krisxia0506/codex-micro/docs/research/assets/README.md

# 产品参考配图

采集日期：2026-10-23。以下图片用于说明参考键盘的外观与控件，不是本项目的样机。

| 文件 | 来源页 | 原始资源 |
| --- | --- | --- |
| `codex-micro-product.png` | [Work Louder 产品页](https://worklouder.cc/codex-micro) | [产品正面图](https://framerusercontent.com/images/HkVNgcwB7n5BW1AUhyku6lIpD4.png?lossless=1&width=1377&height=1394) |
| `codex-micro-command-keys.png` | [Work Louder 产品页](https://worklouder.cc/codex-micro) | [命令键展示图](https://framerusercontent.com/images/bHkJ1NsgylwMciKPLwxa0FzZw.png) |

图片保留原始文件，权利归原权利人所有，不在本项目 MIT 授权范围内；详见 [NOTICE](../../../NOTICE)。未取得额外的再分发或商用授权。

`checksums.sha256` 记录保存文件的 SHA-256，可在本目录运行 `shasum -a 256 -c checksums.sha256` 验证文件完整性。
