krisxia0506/codex-micro/docs/model-workbench.md

# 3D 模型工作台

首版展示和下载同源的概念键盘零件。当前含装配结构试样，不是经过硬件适配或实际打印验证的键盘套件。

v0.22 的按键电气原型另见 [电路图、物料清单与焊接教程](hardware/key-matrix.md)。该教程定义真实的矩阵网络；本页 3D 飞线仍仅展示空间路径，没有同步成 GPIO 接线图。新加二极管和实际线束需要现场验证净空。

## 运行

使用 Node.js 22.12+（或 24/26）与 npm：

```bash
npm ci
npm run dev
```

打开终端输出的本地地址。拖动旋转、滚轮缩放、右键平移；拖动拆解滑杆查看层级。可点击模型或列表选择零件、逐件隐藏、查看线框、恢复全部显示和重置视角。

```bash
npm test
npm run build
npm run export:stl
```

构建生成 `dist/` 静态网站，可部署到静态服务器。单独导出生成 `exports/stl/` 中的 17 个模型零件 STL 和 1 个单底座试配 STL，以及 `exports/manifest.json` 和 `public/codex-micro-stl.zip`。生成物不纳入 Git，由源码重建。网页支持所选零件下载和整套 ZIP 下载。

## 模型与导出约定

- [几何源文件](../web/model.js) 定义零件 ID、几何、组装位置、颜色、拆解层级和说明；[网页入口](../web/main.js) 负责交互，[导出脚本](../scripts/model/export.mjs) 在 Node 中使用同一几何源。
- Z 向上，长度单位毫米。当前外形草案为 110 × 110 mm，底板主体 2 mm（周边及安装位局部 4 mm）、围框 7 mm、轴体板 1.5 mm（螺丝孔周围向下加厚至 2.5 mm）。均为设计假设，不是参考产品的实测尺寸。
- 每个 STL 使用零件局部坐标并落到 Z=0；不会把网页拆解位移写进打印文件。STL 自身不记录单位，在切片器选择 mm。
- 低位定位板按轴体位置开 14.2 mm 方孔，孔宽与板厚仍待实物验证。键帽已含底部空腔和 MX 十字安装盲孔；旋钮和摇杆帽仍为实心占位件，没有实际连接接口。
- 底板、围框、定位板为三个独立样件，已有定位凸沿、螺丝支柱和一体底座卡槽；开发板固定、USB 开孔及功能控件接口尚未完成，不能直接装成可用键盘。
- 模型结构由参数和循环构造，改动尺寸需同步评估壁厚、孔位、间隙。当前不提供网页在线改尺寸或 STEP/B-rep CAD。

## 验证范围

自动测试对全部 STL 回读，检查有限坐标、每条边恰好连接两个面、边方向一致、正体积以及打印底面 Z=0。对齐矩形孔的三角化会产生 T 接点，几何生成器会分割对应边，保证邻接完整。

这些检查不代替切片和实物验证。打印前在切片器确认尺寸、摆放、支撑和最小特征；材料收缩、打印间隙、结构强度及装配需要样件测试。下一步确定轴体、PCB、编码器、接口与紧固方式后再完善工程结构。

## 历史 v0.2 外观与电子布局（已由 v0.3 飞线方案替代）

外壳使用圆角轮廓，键帽增加倒角；展示增加按键字符、状态灯窗、旋钮滚花、摇杆防滑环。圆角和键帽倒角进入同源 STL；字符、灯窗、滚花与丝印属于网页渲染细节，不包含在 STL 中。

新增 16 个电子占位件：PCB、10 个机械轴体、编码器、摇杆模块、USB-C、主控和电源芯片。PCB 展示焊盘、固定孔、丝印与示意走线；没有电路网表和可制造 PCB 数据。界面可切换“仅看电子层”，标注跟随旋转和拆解更新，点击标注查看对应说明。完整组装时默认不显示内部标注，拆解或隐藏上盖后显示。

所有电子位置、尺寸与外形仅用于布局交流，不能视为供应商尺寸或已通过装配检查。没有选择集成麦克风或电池方案，因此没有虚构其确定安装位置。电子件设为不可打印，网页禁止单件 STL 导出，整套 ZIP 仍仅包含 15 个外观打印试样。

全部 12 个键帽（任务键、命令键、语音键和发送键）、旋钮及摇杆帽，共 14 个零件，在零件列表中归为默认折叠的“键帽组”。展开后可选择单键、控制显隐和下载；组复选框控制全部键帽、旋钮及摇杆帽显隐，部分隐藏时显示半选状态。点击模型中的键帽会自动展开分组。分组只改变展示层级，不合并打印几何；电子轴体归入独立的“轴体组”。

## v0.3 手工飞线结构（架构沿用，布局由 v0.4 更新）

按用户确定的方向取消整块键盘 PCB，仅保留 XIAO nRF52840 Sense Plus 开发板，键轴通过软线连接主控。原来独立的 MCU、电源管理与 USB-C 占位移除，相关功能统一在开发板示意中展示。

开发板外形按 [Seeed 官方资料](https://wiki.seeedstudio.com/XIAO_BLE/) 的 21 × 17.8 mm 比例建模。官方确认 Sense Plus 配备 PDM 麦克风与 IMU。展示中的元件位置、高度和焊盘仅为示意，并非官方精确 CAD。USB 插拔空间、固定方式、麦克风声孔及天线净空尚未做工程验证。

轴体底部放置一组 10 个热插拔底座，其下为打印承托框组。用户已确认凯华 Kailh MX 热插拔底座，具体料号和尺寸尚待核对；承托框内孔 14.6 × 6.6 mm 是布局假设，没有实际锁止卡扣，也没有与外壳连接的结构，不能直接用于固定实物。新增的第 16 个 STL 是承托框位置试样，必须按底座型号调整后才能做装配件。也可改为轴体直接焊线方案。

蓝色与棕色软线仅表达底座到开发板的走线空间，**不是接线图**：端点不对应实际 GPIO，尚未确定矩阵或直连、二极管方向、旋钮及摇杆配线、供电方案和固件。不得按此展示焊线。线束可以独立隐藏，与电子层一起拆解；不进入打印包。

网页“仅看电子层”包含底座承托框，以展示底座与打印件的关系。尚未进行实际打印、插拔寿命、焊接和电气测试。

## v0.4 参考图布局修正（布局沿用）

对照仓库已有[官方正面参考图](research/assets/codex-micro-product.png)与[命令键参考图](research/assets/codex-micro-command-keys.png)，将原先错误的两排三列任务键改为四列骨架：第一排为旋钮、两枚任务键、摇杆；第二排四枚任务键；第三排快速模式、批准、拒绝、分支对话；第四排为左侧圆形触控区外观、居中双宽语音键、右侧发送键。

12 枚可见键帽对应 13 个轴体位置，语音键下方两轴。轴体、底座及承托框同步到新布局，XIAO 飞线结构保持。打印包现在有 18 个 STL，旧包和旧键号（尤其 key-10/key-11/key-12）不可混用。

键帽采用封闭凹面网格，凹面同步进入 STL。任务键的半透明材质、中心圆点、命令图标、旋钮斜槽和四角螺钉是渲染细节，不作为可装配结构。圆形触控区也仅为外观示意，没有实现触控电路。参考图用于布局和比例对照，110 mm 方形外壳、键距和高度均为自研设计假设，不能视为官方实测尺寸或 1:1 工程复刻。宽键的双轴固定、行程与稳定性仍待验证。

## v0.5 悬浮按键结构（历史）

取消原先 Z=17 的高位上盖及键帽轮廓孔，改为 Z=10、厚 1.5 mm 的低位轴体定位板，围框高度从 14 mm 降为 7 mm。键帽下沿仍在 Z=18，定位板顶面为 Z=11.5，因此按键侧面和轴体上部外露。定位板仍使用 `top.stl` 文件名，但结构与旧版不兼容。

定位板改为 13 个 14.2 mm 轴孔（宽语音键下两个），不再用上盖围住键帽。孔宽、板厚和卡扣适配仍是待验证假设；并非官方结构尺寸。XIAO、热插拔底座与飞线方案保留。外露式结构与最终固定、绝缘、支撑设计仍需实物检验。

## v0.6 可装配外壳与底座卡位（结构沿用）

网页的「固定结构」展示上下凸沿、三层壳体及紧固件；「底座卡槽」单独展示连体承托槽与底座的对应位置。底座卡位已并入 `bottom.stl`，旧的 `socket-carriers.stl` 不再导出。整套 ZIP 增加 `socket-fit-coupon.stl`，网页也可单独下载此试配件。

### 尺寸依据

采用凯华普通 MX 底座 **PG151101S11 / CPG151101S11**，不使用 Choc 矮轴底座尺寸。来源为 [凯华产品页](https://kailhswitch.net/products/kailh-hot-swap-pcb-socket-diy-mechanical-keyboard-switches)和 [凯华原厂尺寸图（Keyboardio 镜像，2016-04-11，单位 mm）](https://github.com/keyboardio/keyswitch_documentation/blob/master/datasheets/Kailh/PG151101S11-MX-Socket.pdf)。图纸标注：

| 项目 | 图纸尺寸（mm） |
| --- | --- |
| 焊脚总跨度 | 14.50 ± 0.15 |
| 塑料主体上缘宽度 / 基部宽度 | 11.30 ± 0.15 / 10.90 ± 0.10 |
| 最大深度 | 5.89 ± 0.10 |
| 主体厚度 / 包含插孔凸台总厚度 | 1.85 ± 0.10 / 3.05 ± 0.05 |
| 两插孔横向间距 / 纵向错位 | 6.35 ± 0.10 / 2.54 ± 0.10 |
| 插孔凸台直径 | 2.90 ± 0.05 |

相对于轴中心的插孔位置为 `(-3.81,-2.54)`、`(2.54,-5.08)`，由 [KiCad 官方 MX 封装](https://github.com/KiCad/kicad-footprints/blob/master/Button_Switch_Keyboard.pretty/SW_Cherry_MX_1.00u_PCB.kicad_mod)的轴中心孔与电气引脚位置核对。模型独立按尺寸重建，异形轮廓的小圆角简化，不是厂家原始 CAD；这些公开尺寸不代表已经确认用户手中所有批次的公差。

### 实际加入的结构

- 底板上的 13 个安装座与底板做实体布尔合并，每个有承压底面、轮廓侧限位、两处隔离弹性舌及防脱肩。侧面焊脚开窗用于焊接和飞线；槽轮廓额外放宽 0.25 mm，属于打印设计间隙，不是厂家尺寸。
- 上下板各有一圈高 1.6 mm、宽 1.6 mm 的凸沿，外侧轮廓 103.4 mm；中框内侧 104 mm，单边留 0.30 mm。中框支柱在凸沿对应位置避让，避免内侧相撞。
- 凸沿用于嵌合定位，**不承担独立防脱锁紧**；四角 M3 螺丝负责锁紧。螺丝中心为 `(±46,±46)` mm，三层同轴通孔直径 3.4 mm，中框有连到外壁的支柱。
- 底板背面四个防转六角槽，对边 5.8 mm、深 2.6 mm；配 4 颗 M3 六角螺母（建模对边 5.5 mm、厚 2.4 mm），4 颗 M3 × 12 内六角圆柱头螺丝。螺丝/螺母仅展示，不打印；螺纹细节省略。
- 全局底板范围 Z=-1～3，顶板表面 Z=11.5；螺丝末端 Z=-0.5，不突出底面。导出时每件独立落床，顶板翻转为正面朝下、凸沿朝上，避免大面积悬空桥接。

### 试装顺序与验证界限

1. 先打印单底座试配件，确认底座能压入、焊片可接近、拔轴时防脱肩能保持底座。弹性舌厚度、间隙、材料和打印方向须由此试配确认；未做插拔寿命、受力或热变形试验。
2. 打印底板、中框、轴体板。在底板装入底座并完成飞线，底面放入四颗螺母（可临时用胶带防掉落）。
3. 中框套入底板凸沿，放上轴体板使下凸沿嵌入中框；从顶面交替拧紧四颗 M3 螺丝，避免过紧压坏塑料。后续维护可拆螺丝分离三层。

所有打印件通过闭合网格与 STL 回读检查。三层壳体分别是一个连通实体；实体交集检查验证层间、螺丝与壳体、螺母与壳体、底座与卡槽在静态组装位置无体积穿插，并检查底座上移/下移会碰到防脱肩/承压底面。另对全部 26 根飞线检查与底板卡槽、中框支柱及顶板的实体交集，避免新增固定结构穿线。**几何约束不是实物插拔验证**，也不证明整个键盘已经可用；开发板固定、完整电路、USB 接口、键帽实物配合与控件连接仍未完成。

结构布尔运算采用 [Manifold](https://github.com/elalish/manifold)（Apache-2.0），WASM 随网页构建分发；源码位于 [assembly.js](../web/assembly.js)。

## v0.7 中空键帽与 MX 安装孔（当前）

12 个键帽的底部现在均有真实空腔和带导入倒角的十字盲孔，网页与 STL 同源。普通键一个承力柱/安装孔；语音键两个，位于局部 X=±10 mm，与现有双轴位置一致，**不是通用卫星轴孔距**。不新增两个实际轴体，不改变原来 13 轴的布局。

键帽总高 8.5 mm，底部空腔深 4.7 mm、内轮廓每侧缩进 1.7 mm；最深顶部凹面仍保留至少 1.7 mm 厚度。承力柱外径 5.8 mm，十字孔跨度 4.30 mm、臂宽 1.30 mm、深 4.20 mm，入口 0.35 mm 导入倒角。这些是**打印试配参数**，不是宣称来自厂家公差图的量产配合。参数集中在 `web/assembly.js` 的 `keycapSpec`。

[CHERRY 官方 MX2A 说明](https://www.cherry.de/en-gb/product/mx2a-red)确认键帽装在轴芯上部；本次公开资料检索未取得完整官方键帽配合公差图，因此未把论坛数值当作厂家标准。模型中的轴芯以 4.0 × 1.2 mm 十字包络表示，顶端 Z=19.2，键帽下沿调整至 Z=16，插入深度为 3.2 mm。自动检查确认该示意轴芯在静态装配位置不会与键帽材料相交。

网页新增「查看键帽底部」，可放大检查所选键帽的空腔、承力柱与十字孔；在此视图选择其他键帽可继续检查，点击「返回装配视图」恢复原来的显隐状态。

先单独打印一个普通键帽（如 `key-7.stl`），验证松紧、插拔与完整按压行程，再打印整套。普通与宽键帽仍按开口朝下导出；根据打印机的桥接能力设置支撑，避免支撑堵住十字盲孔。尚未做实物配合、按压行程干涉、宽键双轴同步受力或疲劳验证，旋钮与摇杆帽依然只有外形。

新增测试验证所有键帽是单一连通闭合实体、示意轴芯无静态干涉，并从底部发射射线确认空腔实际开放、十字孔为盲孔、孔臂之间保留材料。所有键帽继续通过 STL 导出回读检查。

零件列表中的 15 个轴体组成员（13 个机械轴体、ENC1 旋转编码器和 JOY1 摇杆模块）与 14 个帽类零件（12 个键帽、旋钮和摇杆帽）分别归入默认折叠分组。分组复选框控制整组显隐；展开后可单独选择或隐藏成员，部分可见时组复选框显示半选状态。点选三维轴体会自动展开轴体组并选中对应项。

### v0.8 整板卡钩打印试版

针对 PLA、0.4 mm 喷嘴、0.12 mm 层高试印出现的小钩头缺损，整块底板 13 处底座卡位及试配件同步更新。钩头宽仍为 2.6 mm，前缘竖直厚度由原来的 0.5 mm（倒角后更薄）增至 0.70 mm；下沿从底座顶面上方开始，以 45° 斜坡向内伸出 0.45 mm，避免直接平伸悬空。保留上侧导入斜面及原有弹性隔离槽，不直接加厚弹性舌而增加压入受力。有效覆盖底座外缘约 0.20 mm。

本版为整板试印文件，底板按导出方向平面朝下、卡位朝上。沿用用户的 PLA / 0.4 mm / 0.12 mm 配置；卡钩区域按无支撑方案试印，其他零件仍须独立检查切片。下沿斜面可能允许少量上移再限位，压入手感、保持力、PLA 卡舌寿命及打印效果待实物验证，不保证一次成功。已保留整套其他零件；旋钮、摇杆帽仍为实心外观件。

### v0.9 背部三角斜坡加强版

按用户标注，将每个钩头背部补为宽 2.6 mm 的实体三角斜坡加强筋，斜坡从钩头顶部连至卡位外侧台阶（水平延伸 1.35 mm、高差 1.40 mm），根部延伸到 Z=3.8 mm 并与卡位实体合并。全部 13 个卡位、试配件、网页模型及整套 STL 同步更新。保留内侧安装净空、导入面、下沿斜坡和两侧隔离槽。

加强筋使卡舌更硬，实际压入所需力和可变形量尚未验证；不能仅凭增加材料断言不会断裂。仍按 PLA / 0.4 mm 喷嘴 / 0.12 mm 层高试印，底板平面朝下、卡位朝上。

XIAO 开发板移至左下无轴体区域，中心坐标为 (-33, -32, 5) mm，飞线终点同步到开发板两侧焊盘。使用包含板体、芯片和 USB 外观的 17.8 × 22.2 × 3.5 mm 保守包络，检查与壳体、底座卡位、热插拔底座、轴体、编码器、摇杆及紧固件的静态干涉。此为摆位修正，开发板固定和外壳 USB 开口仍待设计；v0.9 打印件几何不变。

XIAO 在左下空位原地绕 Z 轴旋转 180°，使 USB-C 朝向外壳 -Y 外侧；PCB、表面元件与焊盘同步旋转，飞线终点通过同一变换计算。干涉检查同步旋转包含 USB 的包络。此修改仅纠正朝向，外壳 USB 开口和插头插入空间尚未设计验证，不能视为已可插线。

### v0.10 开发板定位槽及 USB-C 外侧开口

XIAO 中心调整至 (-30, -43.5, 5) mm，接口外观端面到达 Y=-55.1 mm，外壳边缘为 -55 mm。底板增加一体定位槽：槽腔 18.4 × 21.6 mm（相对 PCB 每侧预留 0.3 mm），边缘承托面 Z=5 mm，中心 14 × 17 mm 避空至 Z=3.8 mm，两侧焊盘开窗。定位槽提供侧向定位及承托，尚无上压锁紧，实际底面器件和焊点需试装核对。

中框 USB 区开 20 mm 宽、Z=4.7 至 10 mm 的开放缺口，底板定位凸沿和顶板下凸沿同步避让，顶板盖住上方，避免中框残留薄悬桥。开口按当前 USB 外观包络留余量，未以实物线缆外壳验证。飞线改为从槽位上方接入焊盘。完整替换本版 bottom、wall、top，勿与 v0.9 壳体混用。底板仍按平面朝下打印。新增测试覆盖槽位承托高度、底部避空、接口朝外和贯通通道；完整包络/线束干涉检查继续执行。

### v0.11 外侧防拔挡墙

USB 两侧各增加 4 mm 宽、1.2 mm 厚的实体挡墙，从底板 Z=3 mm 连至 Z=7 mm，阻挡 PCB 两侧板边向外滑动。中间保留 11 mm USB 通道。开发板向内回移 0.5 mm 至 (-30, -43, 5) mm，板边与挡墙保留 0.3 mm 间隙；接口端面相对外壳内凹约 0.4 mm。开发板从上方放入槽位，不从外侧滑入。

新增检查：就位 PCB 无干涉，向外平移 0.6 mm 后与挡墙接触；两侧挡墙实体存在、中央 USB 通道贯通；三层及飞线无干涉。部件包络检查将 PCB 与较窄的 USB 外伸部分分别建模，避免把接口两侧的空位误判成实物板体。仍未设计上压锁紧，挡墙只提供平面内的防拔限位，实际受力、上翘及线缆适配需实测。

### v0.12 中框 Type-C 小窗口

取消贯通外侧的大缺口及底板独立挡块，恢复中框连续外墙，只保留 10 × 3.5 mm 的矩形 USB-C 窗口（Z=5.75 至 9.25 mm）。PCB 所需的大范围避让改在内侧，止于 Y=-53.8 mm，保留 1.2 mm 外墙挡住板边。顶板外表面保持完整，下凸沿仅在内部避让；底板保留承托槽。中框窗口四周均有实体墙，USB 外观端面仍内凹约 0.4 mm。

窗口按当前接口外观设计值留余量，未核对实物线缆包胶尺寸；35 项原检查及新增四周墙体射线检查验证通过后导出。三层壳体使用本版整套替换。上压锁紧仍未实现。

### v0.13 Type-C 圆弧轮廓与尺寸来源

查阅 [GCT USB4105 厂商产品页](https://gct.co/connector/usb4105)及[厂商尺寸图 B3，DigiKey 镜像](https://mm.digikey.com/Volume0/opasdata/d220001/medias/docus/5492/USB4105.pdf)，母座配合内腔标注宽 8.34 +0.06/-0.02 mm、高 2.56 ±0.04 mm。这是配合内腔，不是外壳开孔尺寸。当前未确认 XIAO 实际连接器料号，不把参考建模当作原厂 CAD。

网页连接器改为带真实中空口的圆弧金属壳及内部舌片。内腔按上述名义尺寸，外壳壁厚 0.30 mm 为示意设计假设。打印外壳的开孔为 10 × 4 mm、两端 R2 的胶囊形，中心高度 7.25 mm；打印余量单独设置，不宣称这是 USB 标准开孔。尺寸来源只引用链接，不复制厂商图纸。

36 项测试包含实际渲染连接器金属壳与打印壳体无干涉、开孔中心贯通、四角保留实体（防止再次退化为矩形）、板边向外止挡。仍需实物接口和线缆试插，未完成连接器高度与 XIAO 实物料号核对。

### v0.14 凯华 MX 底座卡槽重制

用户确认使用凯华 CPG151101S11 系列。按上文链接的凯华 PG151101S11 尺寸图（2016-04-11）独立重建主体弧形轮廓、端部触点凹口及贯通插槽；图纸明确给出插槽 1.20 mm × 0.60 mm、凸台直径 2.90 mm。未标注的模具圆角、端部凹口细节及触点叶片仍为近似重建，并非厂家原始 CAD，未复制或分发厂商模型。

13 个一体卡槽与单底座试配件使用同一主体外包络，沿轮廓留 0.25 mm 单边打印间隙；不向触点凹口内部增加塑料锁舌。承托面维持 Z=5 mm，两个插孔下方各增加 2 × 1.4 mm 避空，底面 Z=3.8 mm；两端 3.1 mm 宽焊片窗口底面降低到 Z=4.4 mm，保留焊接飞线空间。防脱钩保留 v0.9 的斜坡下沿和三角背部加强筋。未标注的圆角为近似值，0.25 mm 间隙及避空尺寸是打印设计参数，不是厂家公差。

自动验证覆盖 13 个卡槽与底座无重叠、插孔贯通、焊片窗口和触点底部避空、上下方向承托/防脱、底板连通及 STL 封闭性。全套导出版本为 0.14；PLA / 0.4 mm 喷嘴 / 0.12 mm 层高的实物松紧和防脱力尚未验证。XIAO / Type-C 延续 v0.13 的未验证几何，不能宣称按 Sense Plus 官方完整模型适配。

### v0.15 实物照片校正底座与卡槽方向

用户照片 IMG_6941 显示 v0.14 打印槽的错位方向与插孔面朝上的实物不匹配：按照片朝向，实物右侧插孔及焊片较高，打印槽右侧窗口却较低。此前只检查凸台朝上、未检查轮廓手性，结论不完整。v0.14 不应再用作这款实物的适配底板。

保持凸台朝轴体，在单底座局部坐标内关于 Y=-3.805 mm 镜像原轮廓，并同步纠正插孔、触点凹口、焊片窗口、底部避空、弹性舌、防脱钩及飞线起点；不翻转整个底板或开发板槽。当前插孔坐标为 (-3.81,-5.08)、(2.54,-2.54)。上文旧版 (-3.81,-2.54)、(2.54,-5.08) 的坐标及适配说明由本节取代。轴体仍是未带精确引脚的外观包络，不能据此宣称真实轴脚已验证。

新增独立固定坐标检查，验证实物凸出侧有底座实体、对应槽位有承托空间、相反侧退让，以及飞线连接到纠正后的左右端子。所有 STL 更新至 v0.15，底板与试配件必须换用新版。照片用于确认方向，不用于从像素推算尺寸；间隙、圆角近似及实物试装限制同 v0.14。

### v0.16 两种五孔承托上板

IMG_6944/6945 的实物反馈暴露了旧版遗漏：轴体中心柱与两侧定位柱未进入装配检查，底板轴座会挡住柱子。v0.16 移除全部底板轴座，将凯华底座固定到五孔承托上板下方。用户要求两种版本均提供：

- **A / bare**：五孔上板，轴壳外露；只有柱孔定位与插脚夹持，不提供轴壳卡爪锁止。
- **B / framed**：A 的相同五孔上板，加一块 1.5 mm 方孔定位板，14.2 mm 试配开口，表面比承托面高 5 mm。四角支脚与定位板一体，另外四个 1 mm 打印垫片放在板上螺丝头下；用 M3×18 螺丝。A 使用 M3×12。两版均使用四颗 M3 六角螺母。

#### 参考资料与尺寸边界

- [MakerWorld BigNum，Pokzy](https://makerworld.com/en/models/610097-bignum-hot-swappable-and-hand-wired-numpad-macropa)：作者列出分开的 Switch plate、Hotswap plate、Back plate，支持热插拔和直接焊接两种结构。
- [MakerWorld 20/20，Vostok Labs](https://makerworld.com/en/models/2563301-20-20-split-keyboard-handwired-hotswap-wireless)及[作者装配说明](https://github.com/vostoklabs/zmk-config-ortho20_20/blob/main/Media/20_20%20split%20keyboard%20BOM%20and%20manual.md)：先装底座，再以螺丝和隔柱连接热插拔板与轴体板，再插入轴体。仅参考结构，没有复制、改编或再分发它们的模型；不将未获取的 CAD 尺寸当作证据。
- [Cherry MX 原厂资料镜像，第 10-2/10-3 页](https://github.com/keyboardio/keyswitch_documentation/blob/master/datasheets/Cherry/mx_series.pdf)：五孔类型、3.3 mm 底部伸出参考、PCB 面到定位板面约 5 mm、轴顶参考高度 11.6 mm。
- [KiCad 官方 MX PCB 封装](https://github.com/KiCad/kicad-footprints/blob/master/Button_Switch_Keyboard.pretty/SW_Cherry_MX_1.00u_PCB.kicad_mod)：中心孔 4 mm，定位孔 1.7 mm，定位柱位于中心左右 5.08 mm；金属脚孔标称 1.5 mm。

使用轴心为原点、笛卡尔 +Y 向上的俯视坐标，电气脚为 (-3.81,+2.54)、(+2.54,+5.08)。这是将 KiCad 全部坐标减去中心孔，再反转 Y 轴得到的，不能只镜像两个脚或只依据照片轮廓保持原位置。v0.15 虽纠正错位方向，但相对轴心的 Y 原点仍错误，整体须平移 +7.62 mm；新孔位与底座、焊片、飞线一致更新。

打印参数：中心孔 4.4 mm；两定位孔 2.1 mm；两底座凸台孔 3.2 mm（容纳凯华直径 2.9 mm 凸台，不是焊接 PCB 的 1.5 mm 金属脚孔）；板厚 1.5 mm。承托面 Z=11.5，底座主体 Z=8.15～10，凸台顶 Z=11.2，三根塑料柱向下参考长度 3.3 mm，底端 Z=8.2。底座小圆角、内凹腰线仍是图纸约束下的近似重建，腰线也调整以避免标准中心柱被错误的简化外形挡住。图纸尺寸与打印余量不是厂家公差，也不代表已确认照片中轴体厂牌的所有尺寸。

B 定位板表面 Z=16.5，打印垫片 Z=16.5～17.5。键帽展示高度调整为 Z=20.8，按 4 mm 行程后裙边仍高于定位板 0.3 mm；MX 参考轴顶 Z=23.1，键帽十字孔的名义插入深度约 2.3 mm，实际松紧仍需试配。旋钮与摇杆帽继续是实心外观件。

#### 导出和验证

网页有 A/B 方案选择，各自整套下载互不混淆。`exports/bare/`、`exports/framed/` 分别包含装配所需 STL 与 manifest；ZIP 为 `codex-micro-v0.16-bare-stl.zip`（18 STL）及 `codex-micro-v0.16-framed-stl.zip`（20 STL）。A/B 共用五孔单键试配件，已将承托面翻转朝床，轴座朝上；B 方孔板同样宽面朝床、四角支脚向上，垫片平放。旧版底板和上板都应换用新版。旧导出文件为历史版本，不会自动变成 v0.16。

自动几何检查覆盖两版三根塑料柱、两根金属脚与壳体/底座不碰撞、最后 1 mm 插入路径、五孔贯通、底座上下限位、方孔板连接与净空、正确螺丝长度、键帽行程下限、每个导出 STL 的封闭性和落床。它不能代替插拔力、耐久、实际轴体卡爪与打印收缩验证。先打印试配件，再选择 A/B 打印整套。XIAO 的完整官方模型适配与上压锁紧仍未完成。

### v0.17：减薄底板

A/B 两版底板主体由 4 mm 减为 2 mm（Z=-1～1）；周边与中框接触区域、四角螺母座、开发板槽下方局部保留 4 mm。外侧底面仍为连续平面，可直接平放打印。原有凸沿、螺母槽深度、开发板及 USB 高度保持一致，继续使用 A 的 M3×12 / B 的 M3×18，不需要更换其他板件。减薄后的刚度与翘曲仍待 PLA 实物打印验证。整套 ZIP 更新至 v0.17。

### v0.18：仅保留 A，开发板顶部居中

移除 B 方孔定位板、垫片、网页方案切换与 B 打印导出。当前统一下载 `codex-micro-stl.zip`，版本存档为 `codex-micro-v0.18-stl.zip`，包含 18 个 STL（含单键试配件）；`exports/stl/` 为当前 A 方案。上文 A/B 版本说明仅作历史记录。导出时清理旧 A/B 分目录与带 bare/framed 后缀的生成包。

XIAO 中心改为 `(0,53,5)` mm，USB 朝 +Y；底板槽、托座、中框胶囊开口、内侧避让与飞线同步迁移，原底部开口封闭。顶部按键轴座占据原后方空间，因此外壳仅 +Y 端延长 10 mm：外形 110×120 mm，Y 范围 -55～65 mm。键位不移动，底板主体仍 2 mm，局部加强与 M3×12 螺丝沿用。底板、中框、上板应整套替换，不与旧外壳混用。

几何验证包含开发板完整展示包络与壳体/轴座的干涉、顶部 USB 通道及其周边挡墙、26 根飞线与壳体的相交检查。XIAO/USB 仍沿用参考几何，尚非官方完整 CAD，实物适配与刚度仍待验证。

### v0.18 预览修正：轴体组拆解层级

原轴体、编码器和摇杆模块沿用电子层系数 2，低于上板的 2.5，导致拆解越大，轴体反而落在上板下方。现将整个轴体组设为 3.25，处于上板与键帽组（4）之间；组内同步位移。仅修改预览拆解关系，装配坐标及打印几何不变。回归检查覆盖 0%、20%、50%、100% 的层次顺序。

### v0.19：深海 MINI 矮轴参考接口试配版（非实物适配完成）

用户确认更换深海 MINI 矮轴及配套底座。当前唯一 A 方案改用 **CPG135001S30 Choc 底座**，替换旧 CPG151101S11 MX 底座、上板卡槽与全部键帽。保留顶部居中的 XIAO、110×120 mm 外壳、2 mm 底板及 M3×12 紧固件。底板、中框的几何与 v0.18 一致。

**证据范围：**

- [深海 MINI 官方产品页](https://kailhswitch.net/products/kailh-deep-sea-silent-min-low-profile-keyboard-switch)与其[规格图片](https://cdn.shopify.com/s/files/1/0638/3599/6346/files/MINI.jpg?v=1720775796)：白/棕两种轴心、圆形护壁、十字接口、标称总行程 2.8±0.25 mm、整体高度 12.3 mm；产品专属说明明确不兼容 Cherry MX 引脚。页面通用“兼容 Cherry”模板与专属说明矛盾，不能作为兼容依据。
- [Kailh 数据表目录](https://www.kailh.net/pages/product-datasheet)提供的 [CPG135301D01 普通 Choc V2 图纸](https://cdn.shopify.com/s/files/1/0657/6075/5954/files/SPEC-CPG135301D01_Kailh_Choc_V2_Low_Profile_Red_Switch.pdf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)，第 1 页：护壁内/外径 5.5/6.5 mm、十字跨度 4.00±0.05 mm、臂宽 1.30±0.03 mm、中心柱直径 4.8 mm。本版借用这些机械接口作为试配参考，**不宣称已确认深海 MINI 的全部模具尺寸一致**。图纸的普通版行程没有沿用到 MINI。
- [CPG135001S30 厂商图纸镜像](https://raw.githubusercontent.com/keyboardio/keyswitch_documentation/master/datasheets/Kailh/CPG135001S30-Choc-Socket.pdf)：本体包络 9.95×6.85 mm，高 1.85 mm，凸台高 1.2 mm、直径 2.9 mm；焊片总跨度 13.15 mm；两孔间距 5.00×2.20 mm。未标注腰线、圆角与触点凹口独立近似重建，未复制 CAD。
- 找到的 CPG1353S01D01-21 静音 PDF 是 1.8 mm 行程的另一变体，不能充当深海 MINI 的专用图纸；不据此导出精确适配结论。完整 MINI 模具尺寸图仍缺失。

**本版打印参数（设计余量，不是厂商公差）：**

| 项目 | 试配值 |
| --- | --- |
| 键帽总高 / 底腔深度 | 7.5 / 3.8 mm |
| 安装柱外径 | 5.20 mm（旧版 5.80 mm） |
| 十字盲孔跨度 / 臂宽 / 深度 | 4.15 / 1.45 / 2.80 mm |
| 名义插入深度 | 2.50 mm |
| 上板中心孔 / 凸台孔 | 5.20 / 3.30 mm |
| 辅助脚避空 | 1.80 mm；为普通 Choc V2 参考图保留，不表示 MINI 必有此脚 |
| 上板厚度 | 1.50 mm |

护壁位于键帽安装柱外侧，底腔为其留出环形空间；不是把十字槽改成圆孔。检查采用 3.05 mm 最大参考行程，并在固定轴壳中保留移动轴心通道。轴体上板承托面 Z=11.5，参考轴心顶 Z=20.5，键帽下沿 Z=18；这些垂直堆叠尺寸需要与 MINI 实物核对。

采用顶视图 +Y 向上的坐标，电气脚为 `(-5,-3.8)`、`(0,-5.9)`；底座凸台为 `(-5,-3.8)`、`(0,-6)`。图纸之间 0.10 mm 的纵向差由贯通槽宽度容纳，未把电气脚硬改成底座坐标。旧 MX 两侧定位柱取消；同步更新底座腰线、下挂卡槽、斜坡保持肩和飞线焊接起点。外壳、底座、柱脚、焊片、线束交集检查通过，不代表实物插拔寿命或夹持力通过。

整套 `codex-micro-v0.19-stl.zip` 含 18 个 STL。额外提供 `codex-micro-v0.19-mini-fit.zip`：`socket-fit-coupon.stl` 与 `key-1.stl` 两件，网页「下载轴座＋键帽试配包」直接获取。先按 PLA / 0.4 mm 喷嘴 / 0.12 mm 层高试印，验证底座卡紧、轴脚就位、键帽轻压装入、回弹及按到底不顶壳。键帽空腔需在切片器检查桥接/支撑，不要让支撑堵死十字盲孔。不要强压过紧键帽。

网页已检查 MINI 圆形护壁外观、60% 拆解层次及键帽底面；页面加载正常，开发环境仍有 HMR WebSocket 连接提示，必要时手动刷新。现有 XIAO/USB 参考几何、开发板缺少上压固定、旋钮/摇杆帽实心占位等限制仍在。

### v0.20：1350 轴座图纸复核

来源：凯华官方 CPG135001S30，图号 KHA-PG1350-005EN：
https://www.kailhswitch.com/Content/upload/pdf/202115927/CPG135001S30-data-sheet.pdf

复核上缘 9.95±0.15、底部 9.55±0.05、深 6.85±0.05、主体高 1.85±0.1、总高 3.05±0.05、焊片总跨度 13.15±0.15、凸台直径 2.90±0.05 mm、孔距 X=5.00±0.05 / Y=2.20±0.05 mm。旧模型已采用 1350 主尺寸，但漏掉上下宽度区别，本次补齐；上缘厚度图纸未标注，取 0.25 mm 作外观近似。未发布第三方图纸或 CAD。

卡槽继续采用最大上缘轮廓单边放宽 0.25 mm（包络 10.45×7.35 mm），全插入路径保留此尺寸，不能缩至底部宽度，否则上缘无法装入。这项打印余量、未标注圆角以及上缘厚度均非厂商尺寸。定位孔 Ø3.3 为打印避空，图区 PCB 孔为 Ø3.0。网页和导出清单明确显示 1350 完整型号及尺寸，避免与 1511 普通轴底座混淆。

1350 轴座图纸已找到；深海 MINI 轴体完整机械图缺失的问题仍在，键帽、轴体适配和卡槽夹持力仍需实物验证。

### v0.21：底板逐键位轴座承托柱

13 个轴座分别增加一体承托柱。相对每个轴体中心偏移 X=-2.5、Y=-4.9 mm，位于两触点之间的绝缘桥下方。顶部 Ø2.8 mm，根部 Ø5 mm，根部约 2 mm 高的锥形过渡便于打印与加强；保持主体底板厚 2 mm。

装配坐标：底板内表面 Z=1 mm，上板底面 Z=10 mm，轴座主体高 1.85 mm，所以轴座底面 Z=8.15 mm。承托顶面 Z=8.00 mm，相对内底面高 7.00 mm，名义轴向间隙 0.15 mm。打印 STL 为最低面 Z=0，平台顶面对应 STL Z=9 mm；不要把它误认为柱高。

单边间隙是设计余量而非已测量打印精度。原有卡扣继续定位，新增底柱作为插轴受力的刚性后备承托；轴座下移 0.2 mm 时每个柱顶都与绝缘桥相交。几何验证包括 13 个位置逐一承托、正常装配无干涉、触点/焊脚区域避让、上下壳不相交、飞线不相交、底板连通与 STL 封闭。实物图未给定绝缘桥所有细节，接触面仍需要试装确认，不能据此宣称已完成力学验证。

此版需要重新打印底板；轴座卡槽仍在上板，不迁回底板。试配包仅含上板轴座试片与键帽，不含合盖承托柱验证；验证承托高度应使用整套中的 bottom.stl 配合现有上板。

### v0.22：键位下沉与卡扣放松

13 个轴位独立下沉 2 mm，开口 15×15 mm，相对 13.95 mm 轴壳每侧余量 0.525 mm。槽外框 18×18 mm，承托底厚仍为 1.5 mm。键帽、轴体、轴座及显示触点均降低 2 mm；旋钮和摇杆位置不变。承托面 Z=9.5、轴座底面 Z=6.15、底柱顶面 Z=6，内底面 Z=1，因此柱高改为 5 mm，名义间隙仍为 0.15 mm。

“调松 0.5 mm”按总宽增加理解：卡槽单边间隙由 0.25 增至 0.50 mm，最大包络 10.95×7.85 mm。两侧弹舌和间隔槽各向外移 0.25 mm；防脱钩投影从 0.50 调整至 0.65 mm，避免移位后失去保持作用；净扣合量约 0.125 mm，小于原来的 0.225 mm。保留斜坡导入面，减少插入变形需求。底柱继续提供合盖后的后备承托，卡扣松紧与寿命未实测。

必须同时更换 top.stl 和 bottom.stl，不能配旧 7 mm 高承托柱；键帽 STL 几何不变，只改变组装高度，已有键帽可沿用。下沉槽倒置打印后形成约 15 mm 的桥接，需在切片预览中检查并按需支撑槽顶，不宣称无支撑可直接打印。试配件同步加入下沉槽，但不包含底柱，合盖高度需用新底板验证。
