krisxia0506/codex-micro/printable/v0.22/key-1.stl

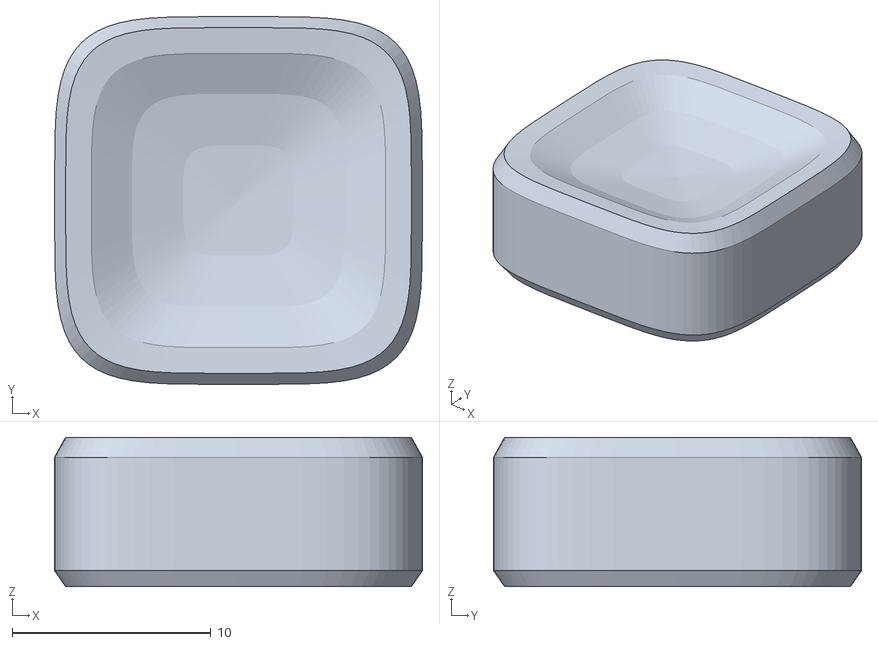
[picture p6: CAD file, 2026-11-08]
printable/v0.22/key-1.stl
18.5 x 18.5 x 7.50
