krisxia0506/codex-micro/printable/v0.22/joystick.stl

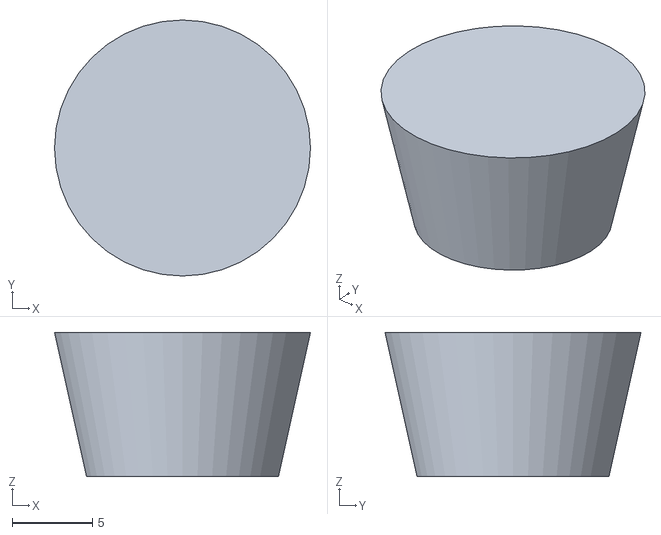
[picture p7: CAD file, 2026-11-08]
printable/v0.22/joystick.stl
16.0 x 16.0 x 9.00
