krisxia0506/codex-micro/printable/v0.22/top.stl

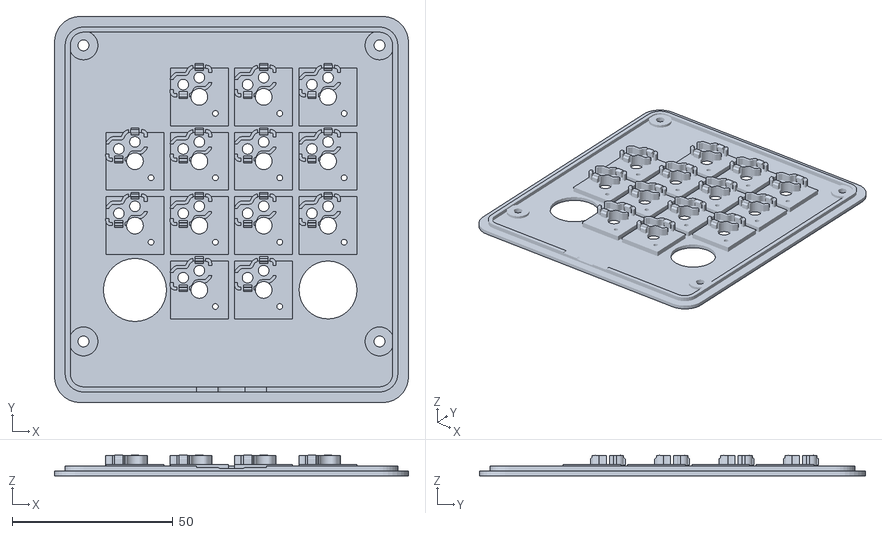
[picture p8: CAD file, 2026-11-08]
printable/v0.22/top.stl
110.0 x 120.0 x 6.50
