krisxia0506/codex-micro/printable/v0.22/bottom.stl

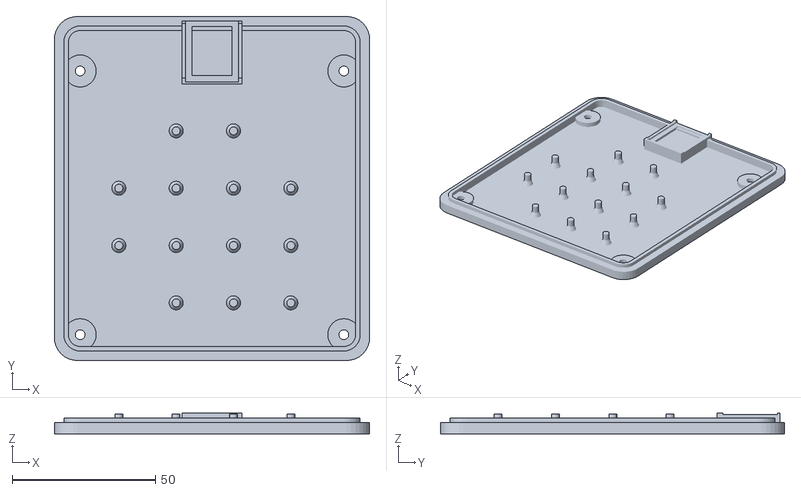
[picture p9: CAD file, 2026-11-08]
printable/v0.22/bottom.stl
110.0 x 120.0 x 7.20
