krisxia0506/codex-micro/printable/v0.22/socket-fit-coupon.stl

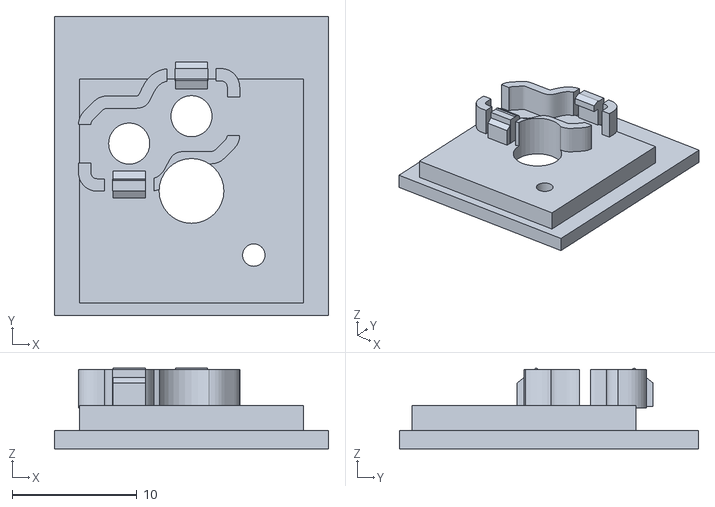
[picture p10: CAD file, 2026-11-08]
printable/v0.22/socket-fit-coupon.stl
22.0 x 24.0 x 6.50
