krisxia0506/codex-micro/printable/v0.22/key-11.stl

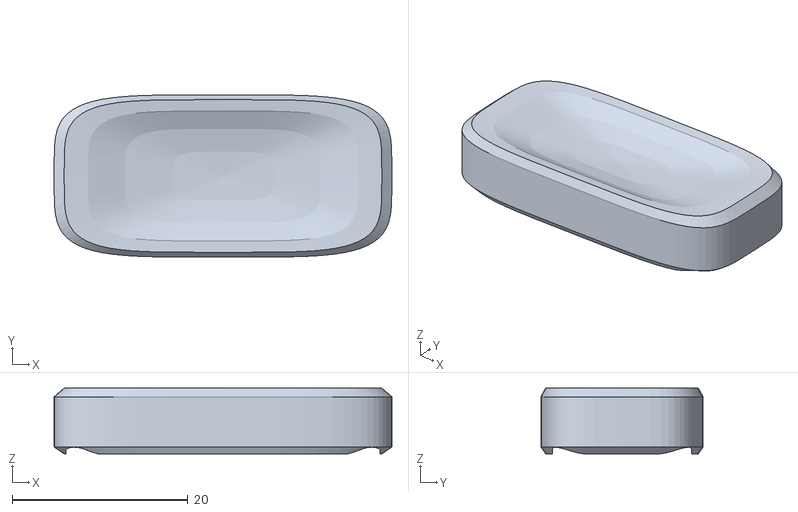
[picture p11: CAD file, 2026-11-08]
printable/v0.22/key-11.stl
38.5 x 18.5 x 7.50
