krisxia0506/codex-micro/printable/v0.22/wall.stl

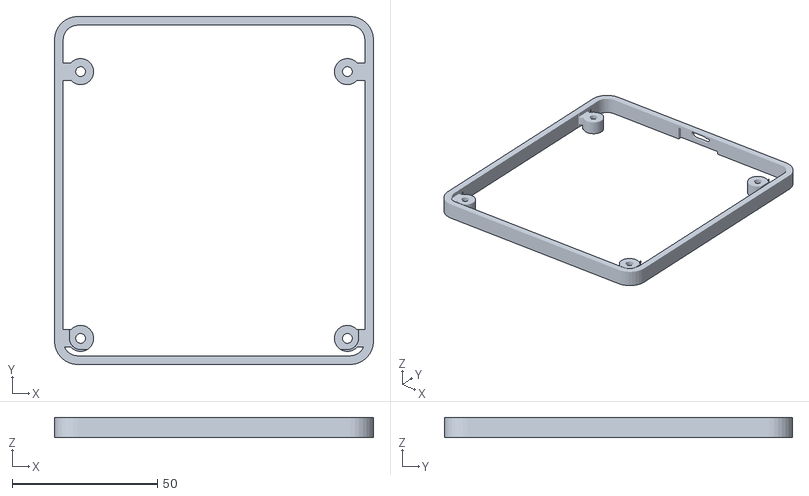
[picture p12: CAD file, 2026-11-08]
printable/v0.22/wall.stl
110.0 x 120.0 x 7.00
