krisxia0506/codex-micro/printable/v0.22/knob.stl

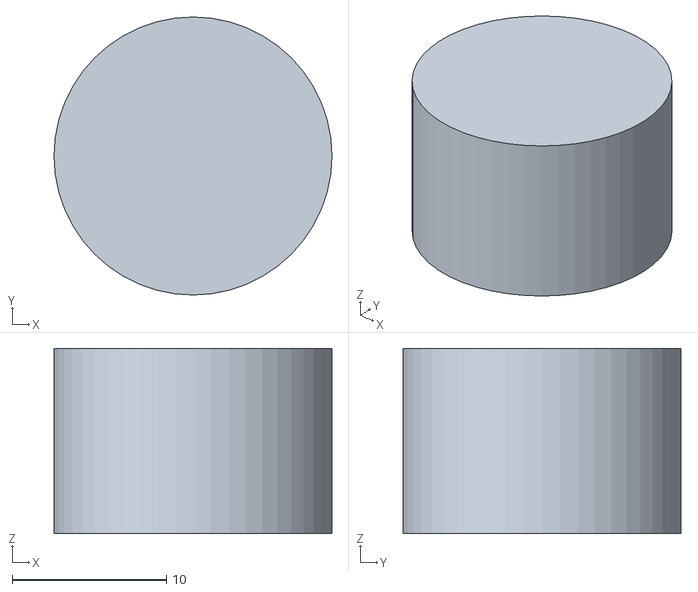
[picture p13: CAD file, 2026-11-08]
printable/v0.22/knob.stl
18.0 x 18.0 x 12.0
