krisxia0506/codex-micro/printable/v0.22/PRINTING.txt

Codex Micro v0.22 / A - MINI low-profile reference-fit prototype
Units: mm. Enclosure 110 x 120 mm. XIAO centre (0,53,5), USB faces +Y. Bottom floor 2 mm, local mounts 4 mm. Four M3x12 screws and M3 nuts.
Requires Kailh CPG135001S30 Choc sockets. OLD CPG151101S11 MX SOCKETS DO NOT FIT. From v0.21 replace BOTH top.stl and bottom.stl: recessed carrier and shorter pedestals must be paired. Existing keycaps, sockets and midframe are reusable.
The exact Deep Sea MINI mould drawing has NOT been obtained. Mechanical interface is based on Kailh CPG135301D01 Choc V2 drawing, with MINI 2.8 +/-0.25 mm travel from its official product page. The silent -21 PDF is a DIFFERENT travel variant and was NOT used as the MINI specification. Unspecified mould curves are approximations; no third-party CAD redistributed.
1350 socket drawing KHA-PG1350-005EN: upper width 9.95 +/-0.15, lower width 9.55 +/-0.05, depth 6.85 +/-0.05, body height 1.85 +/-0.1, overall terminal span 13.15 +/-0.15, collar diameter 2.90 +/-0.05, total height 3.05 +/-0.05. Rim thickness 0.25 is an UNDIMENSIONED modelling assumption. Pocket uses maximum upper profile plus 0.50 mm per side through the insertion path (overall pocket envelope 10.95 x 7.85); do not constrict entry to lower width. Collar relief 3.3 mm is a PRINT allowance, not the drawing PCB hole 3.0 mm.
Bottom supports: one per switch, offset (-2.5,-4.9) mm from switch centre. Interior floor Z=1, support top Z=6, socket underside Z=6.15: height above floor 5 mm, nominal gap 0.15 mm. Top diameter 2.8 mm, tapered foot diameter 5 mm. The top touches insulating central bridge, not contacts. Gap is a design allowance, NOT verified print tolerance. Check seating with enclosure screws lightly tightened; never force a warped plate closed.
Each switch recess is 15 x 15 mm, with an 18 x 18 mm outer cup and 1.5 mm floor. Carrier seat Z=9.5 instead of 11.5; switch, socket and keycap all lowered by 2 mm. Retaining tongues move outward 0.25 mm on each side; hook overlap reduced to approximately 0.125 mm with a sloping lead-in.
Carrier holes: centre 5.2 mm, socket collars 3.3 mm, auxiliary relief 1.8 mm. Contacts (-5,-3.8) and (0,-5.9); socket collars (-5,-3.8) and (0,-6). The 0.1 mm difference is accommodated inside the socket slots, not silently changed to match.
Keycap: height 7.5, cavity 3.8, mounting boss diameter 5.2, cross 4.15 x 1.45, blind depth 2.8, engagement 2.5 mm. Guard inner/outer 5.5/6.5 mm are CHOC V2 REFERENCE dimensions, not confirmed MINI measurements. All print allowances are design assumptions.
PRINT THE TWO-PIECE FIT KIT FIRST: socket-fit-coupon.stl plus key-1.stl. PLA / 0.4 mm nozzle / 0.12 mm layers. Carrier/coupon exported face down and holders up: the new 2 mm recess creates a 15 mm bridge under each floor. Inspect slicer preview and support these recess ceilings as needed; this revision is not claimed support-free. The fit kit does not validate bottom-pedestal height; use the matching full bottom plate for that. Keycap is hollow: inspect slicer bridges/support and do not fill the blind mounting hole with support. Seat the Choc socket, insert the switch, then fit the cap. Check retaining shoulders, three pin clearances, light seating force, full return and bottom-out clearance before printing the whole set. Do not force a tight cap; printed fit and strength remain unverified.
A does not latch the switch housing. XIAO/USB geometry is provisional; knob and joystick cap are solid appearance pieces.
Sources:
https://www.kailhswitch.com/Content/upload/pdf/202115927/CPG135001S30-data-sheet.pdf
https://kailhswitch.net/products/kailh-deep-sea-silent-min-low-profile-keyboard-switch
https://www.kailh.net/pages/product-datasheet
https://raw.githubusercontent.com/keyboardio/keyswitch_documentation/master/datasheets/Kailh/CPG135001S30-Choc-Socket.pdf
