krisxia0506/codex-micro/(commit log)

2026-10-23 chore: 初始化支持语音输入的开源 Codex Micro 键盘项目
2026-10-29 chore: 完善开源仓库 CI 与维护规范 (#2)
    ## 改动说明
    仓库已公开并采用 MIT 许可证，但缺少自动检查和主分支保护。补充文档链接目标、素材 SHA-256 与补丁空白检查，固定 Actions
    提交并通过 Dependabot 每周更新，完善 README、贡献指南、安全报告入口和维护设置说明。
    已应用并回读 GitHub 设置：main 必须 通过 PR、Repository
    checks、分支更新和讨论解决后合并，禁止强推和删除，仅允许 squash merge。保留现有许可证及第三方素材权利说明。现有硬件方案 PR
    不包含在本次改动中。
    ## 验证结果
    - 本地 `python3 scripts/check_repository.py` 通过。
    -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
2026-11-08 docs: 明确九键协议路线与 LE Audio 麦克风待验证方案 (#1)
    为 Codex Micro 开源键盘整理多个硬件候选方案，区分控制协议与内置麦克风音频链路。README 提供九键控制和 LE Audio
    调研入口，明确内置电池、USB 有线与蓝牙无线的整机目标仍处于设计阶段。
    - void9 + Pro Micro（ATmega32U4）：保留原版对应九键布局 Agent 1 / Agent 2 / Agent
    3；Fast / Approve / Decline；Fork / Mic / Send，参考 fpad LUFA/USB 厂商 HID
    移植路线。
    - ESP32：参考 Core2 的 BLE 厂商 HID 实现，保留物理九键适配及逐项快捷键降级边界；原创 SVG
    展示控制协议与电脑麦克风原型链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
2026-11-08 feat: 搭建 3D 模型拆解工作台与 STL 导出 (#3)
    提供 Codex Micro 三维拆解工作台和毫米制 STL 下载，采用 A 承托上板方案、深海 MINI / Choc V2 参考轴体与
    CPG135001S30（1350）热插拔底座。外壳 110×120 mm，XIAO 顶部居中、Type-C 朝外，四角 M3×12 紧固。
    当前 v0.22 将 13 个机械轴位下沉 2 mm：15×15 mm 槽口、18×18 mm 外框、1.5 mm
    槽底。键帽、轴体、轴座、显示触点和飞线同步调整。底板承托柱由 7 mm 降为 5 mm，仍对准各轴心偏移 (-2.5,-4.9) mm
    的绝缘桥，保留 0.15 mm 名义间隙。必须配套更换 top.stl 与 bottom.stl；已有键帽可沿用。
    卡槽总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
    [bottom.stl, joystick.stl, key-1.stl, key-10.stl, key-11.stl, key-12.stl, key-2.stl, key-3.stl]
2026-11-08 docs: 添加项目开发与中文审阅协作指南 (#4)
    新增项目级
    AGENTS.md，为后续代理开发和审阅提供与实际仓库结构一致的协作规则。涵盖项目阶段与硬件候选路线边界、任务修改授权、几何与展示职责、尺寸联动检查、版本化打印快照、验证命令、Git/PR
    交付、来源许可与中文审阅要求。
    重点约束网页和 STL 同源、轴座/承托柱/键帽/飞线的装配一致性，以及几何测试不能代替实物验证。区分默认忽略的生成物与 printable
    下明确保存的快照，并要求单独校验打印 SHA256SUMS。现有 CONTRIBUTING.md、维护说明和 PR
    模板通过链接引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
2026-11-08 docs: 添加十三键矩阵电路与手工焊接教程
2026-11-08 test: 验证按键扫描并记录 Sense Plus 编译配置
2026-11-08 docs: 按键盘背面布局绘制分步接线图
