krisxia0506/codex-micro/(notices)

Notices in the files:
README.md:
License: MIT
